DhruvTrehan03/Stretchy/Images/iCloud Photos/iCloud Photos/IMG_7711.JPEG

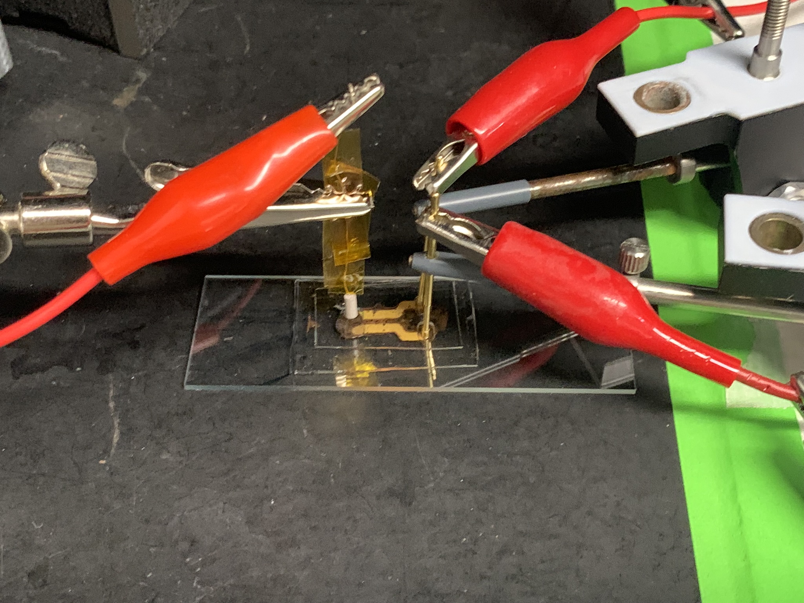
Images/iCloud Photos/iCloud Photos/IMG_7711.JPEG
