DhruvTrehan03/Stretchy/Images/iCloud Photos/iCloud Photos/IMG_7752.JPEG

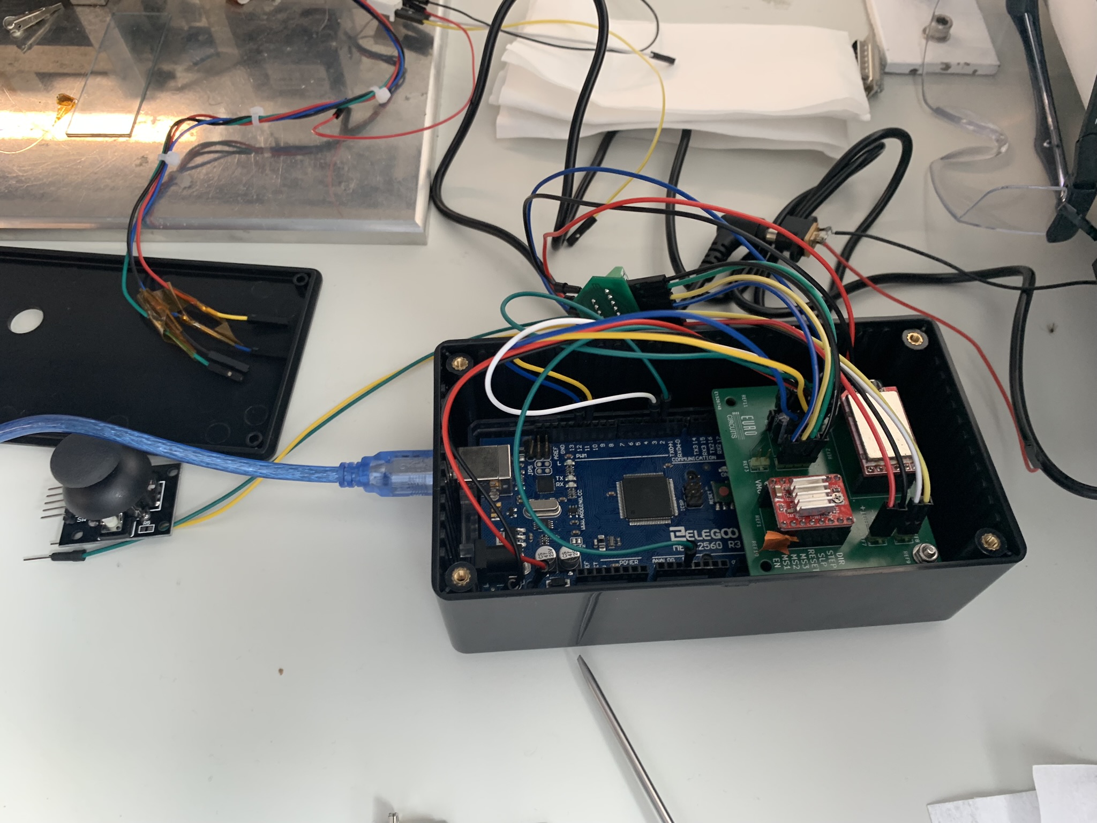
Images/iCloud Photos/iCloud Photos/IMG_7752.JPEG
