DhruvTrehan03/Stretchy/Documentation.docx

- To laser-cut the PDMS, best is to place the whole disk in the laser cutter with the die tape on it. Cut with:
  - Power: 7%
  - Speed: 2%
  - PPI: 1000
  - Z-axis: 1mm

The PDMS should be cut twice to ensure that it is fully cut.

- After the base layer has been coated with the gold (using the 3D printed template), use some PDMS to stick the top layer of PDMS onto the base layer (with the die tape still on it)
- The spin settings for both the PDMS and PEDOT is: 5 seconds at 500 rpm and 30 seconds at 1000
- Drop in the PEDOT into the holes and spin coat 3 times, placing the sample on the hot bed for approximately 30 seconds in between each coat
- After coating leave on a 150C hot plate for about 2 minutes

Using the GUI:

Select SMU unit from dropdown menu (should have INSTR)

Choose COM Port Arduino is connected to (Should be visible in device manager or in the Arduino ide)

Write Command in the format F100, D1000, B100, ensuring you use capital letters and a space between the comma and the letter, only write a number in the data points section
