DhruvTrehan03/Stretchy/Images/iCloud Photos/iCloud Photos/IMG_7627.JPEG

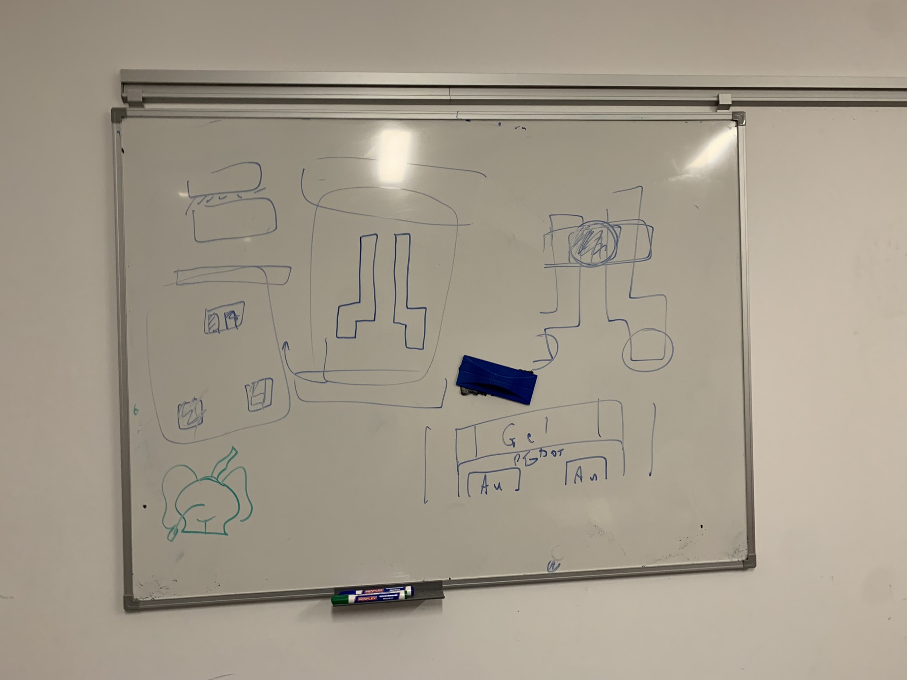
Images/iCloud Photos/iCloud Photos/IMG_7627.JPEG
