DhruvTrehan03/Stretchy/Images/iCloud Photos/iCloud Photos/IMG_7643.JPEG

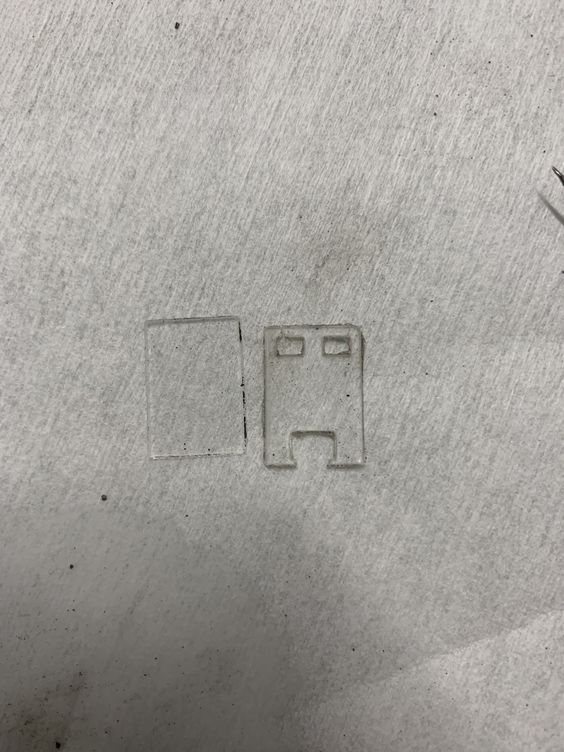
Images/iCloud Photos/iCloud Photos/IMG_7643.JPEG
