DhruvTrehan03/Stretchy/Images/iCloud Photos/iCloud Photos/IMG_7647.JPEG

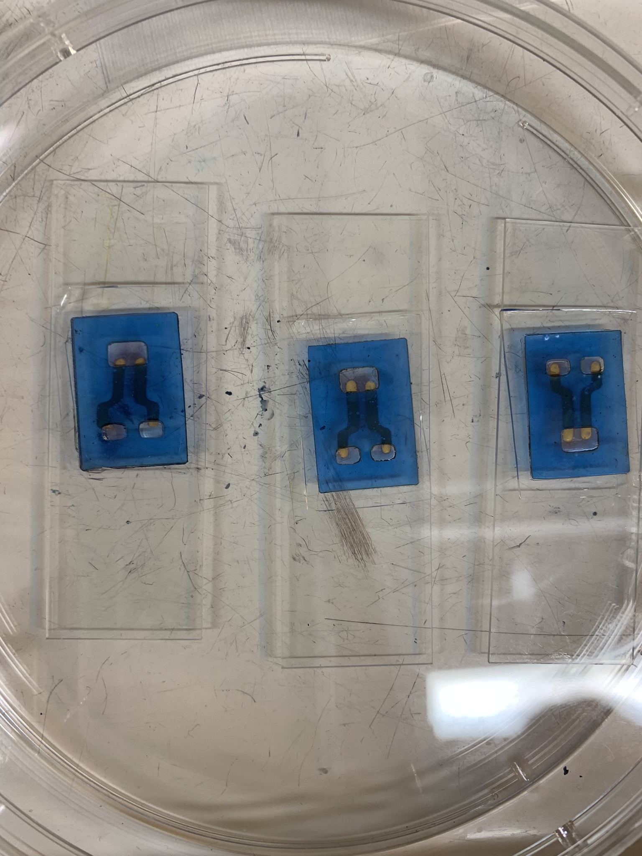
Images/iCloud Photos/iCloud Photos/IMG_7647.JPEG
