DhruvTrehan03/Stretchy/Images/iCloud Photos/iCloud Photos/IMG_7648.JPEG

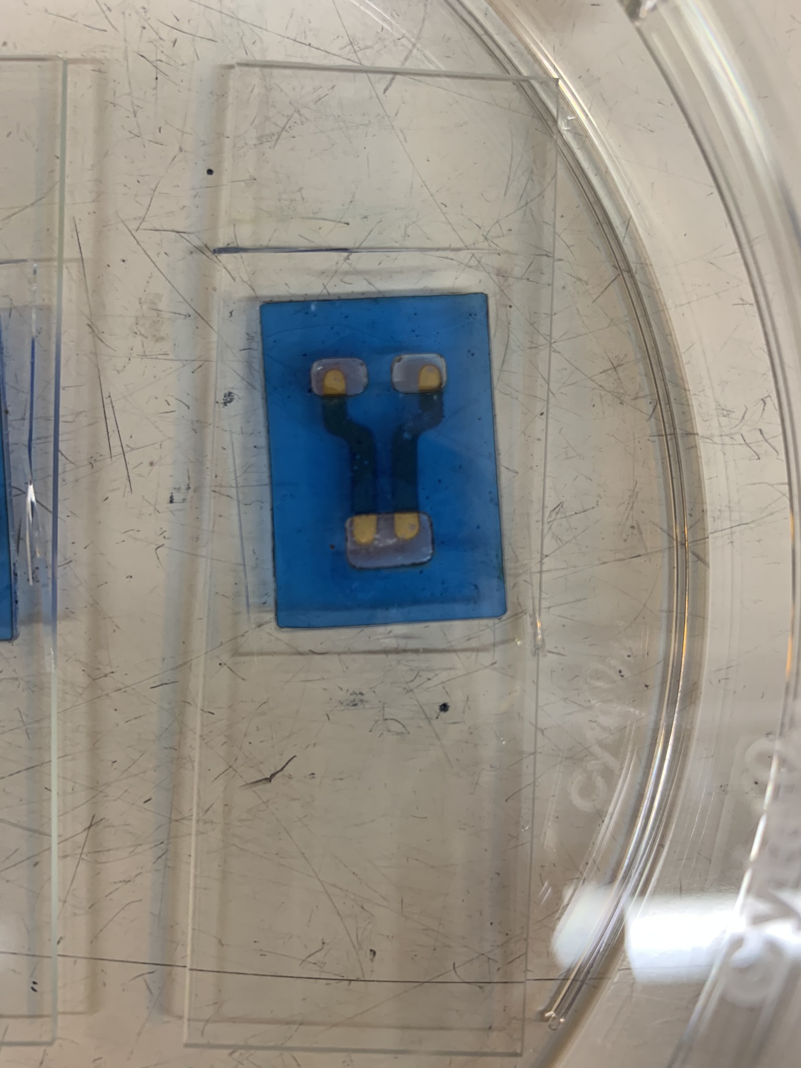
Images/iCloud Photos/iCloud Photos/IMG_7648.JPEG
