DhruvTrehan03/Stretchy/Images/iCloud Photos/iCloud Photos/IMG_7704.JPEG

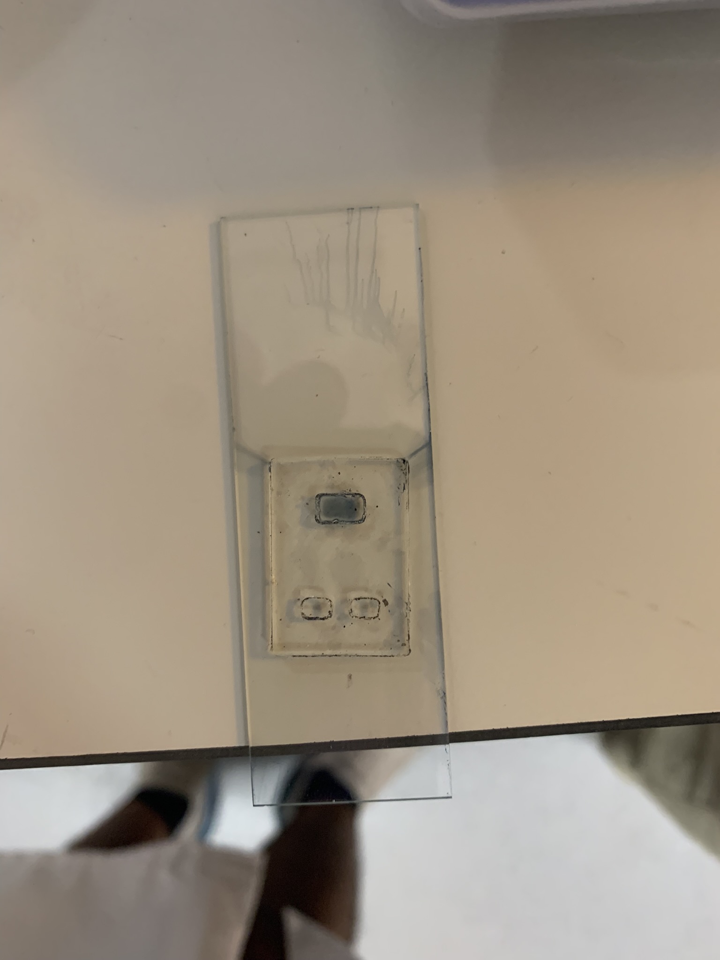
Images/iCloud Photos/iCloud Photos/IMG_7704.JPEG
