DhruvTrehan03/Stretchy/Images/iCloud Photos/iCloud Photos/IMG_7705.JPEG

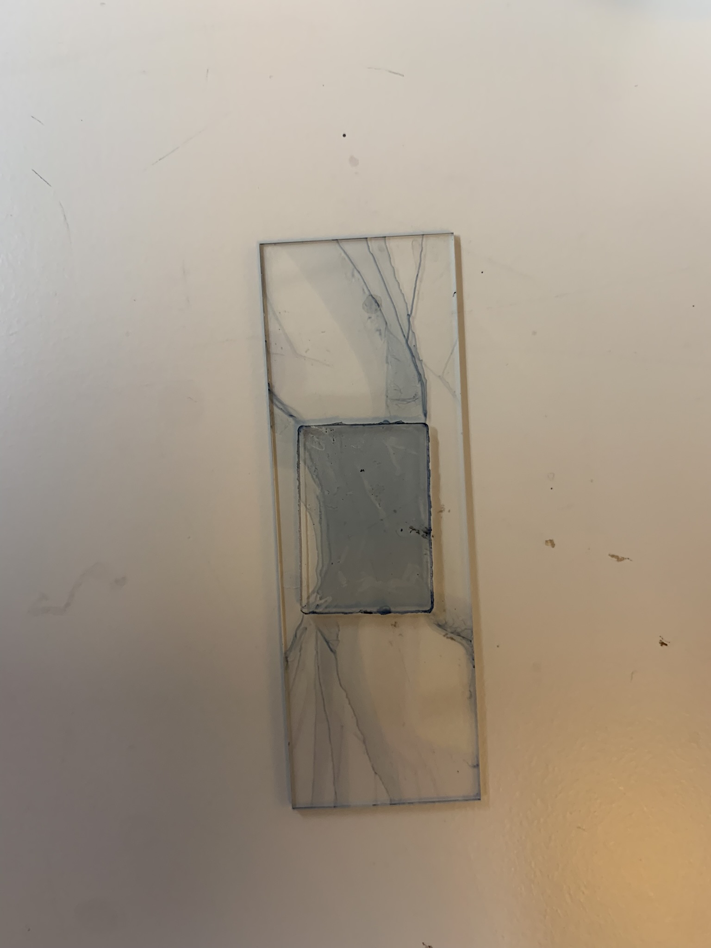
Images/iCloud Photos/iCloud Photos/IMG_7705.JPEG
