DhruvTrehan03/Stretchy/Images/iCloud Photos/iCloud Photos/IMG_7708.JPEG

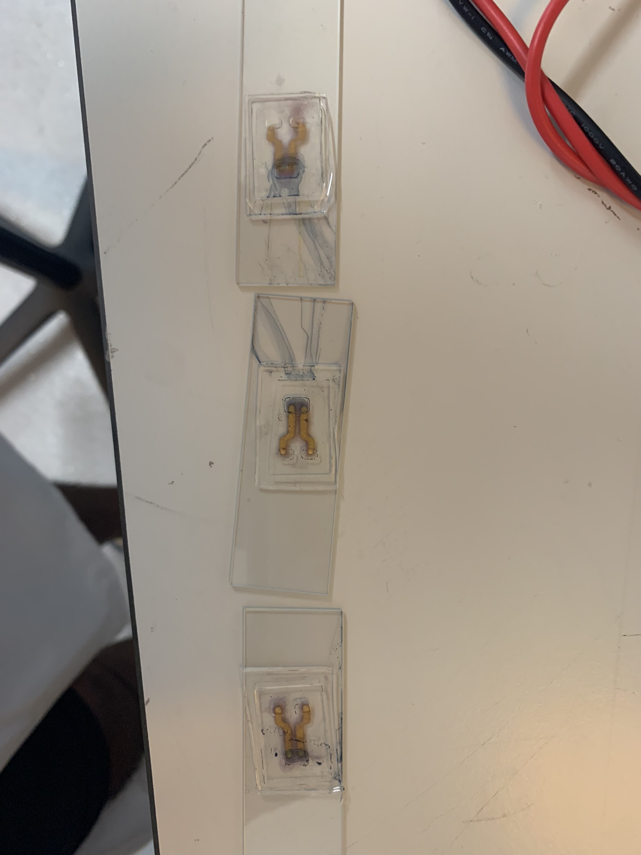
Images/iCloud Photos/iCloud Photos/IMG_7708.JPEG
