DhruvTrehan03/Stretchy/Images/iCloud Photos/iCloud Photos/IMG_7710.JPEG

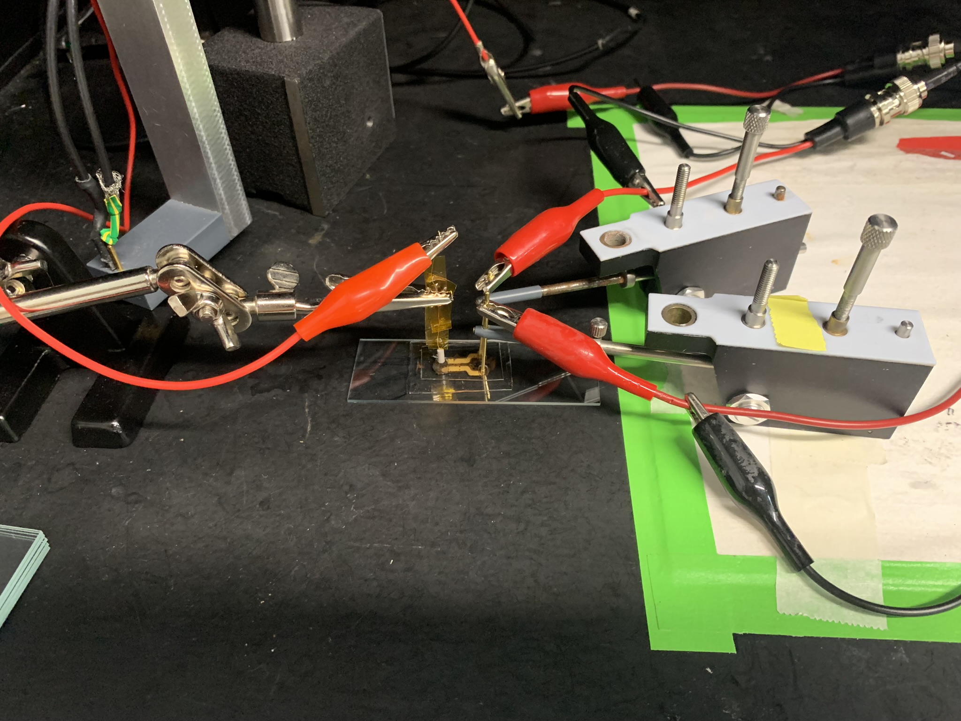
Images/iCloud Photos/iCloud Photos/IMG_7710.JPEG
