DhruvTrehan03/Stretchy/Images/iCloud Photos/iCloud Photos/IMG_7751.JPEG

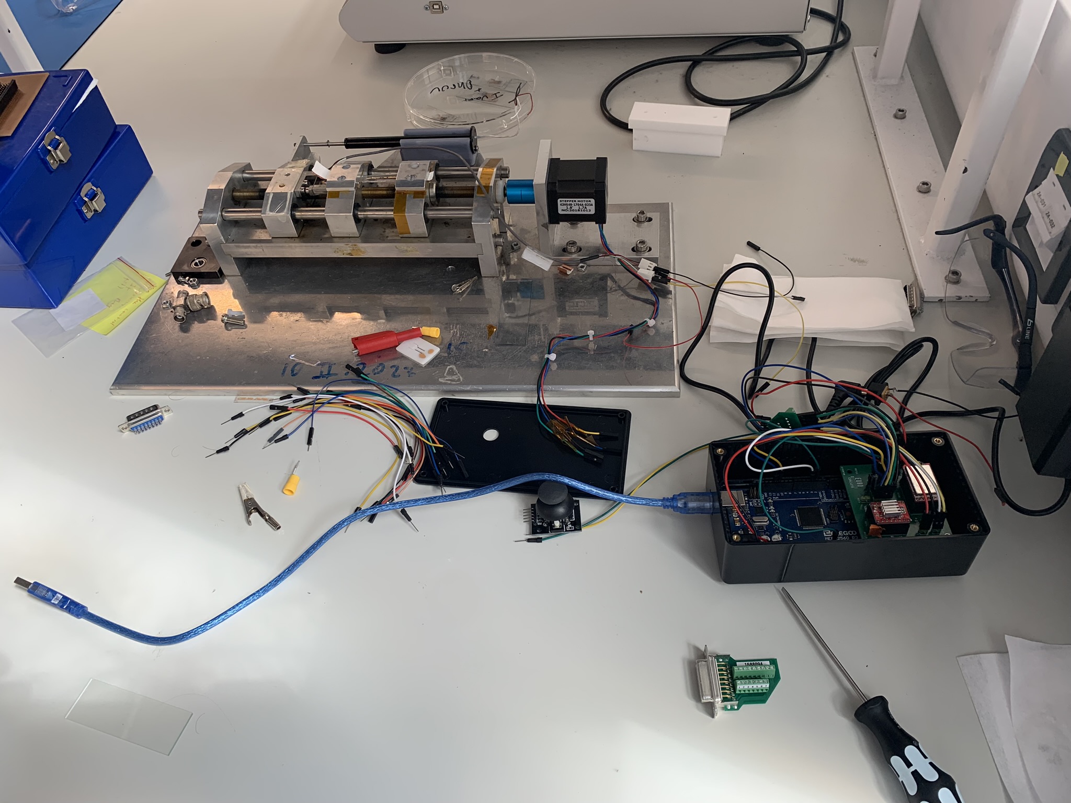
Images/iCloud Photos/iCloud Photos/IMG_7751.JPEG
