DhruvTrehan03/Stretchy/Images/iCloud Photos/iCloud Photos/IMG_7753.JPEG

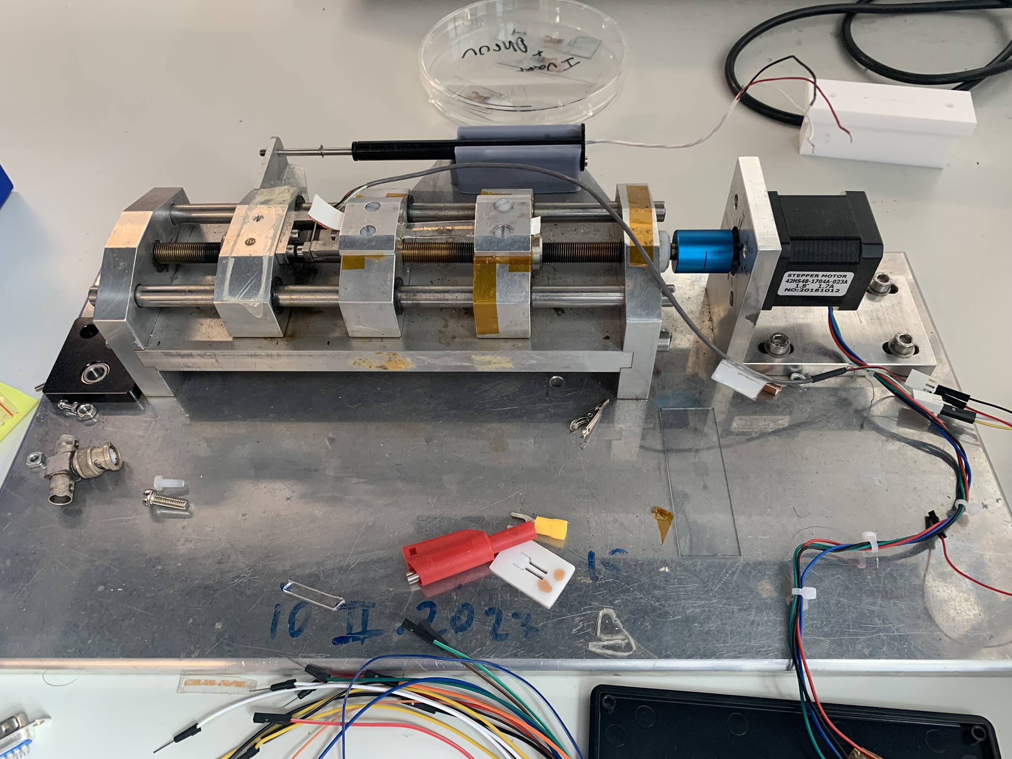
Images/iCloud Photos/iCloud Photos/IMG_7753.JPEG
