DhruvTrehan03/Stretchy/Electrode_sketch.dxf

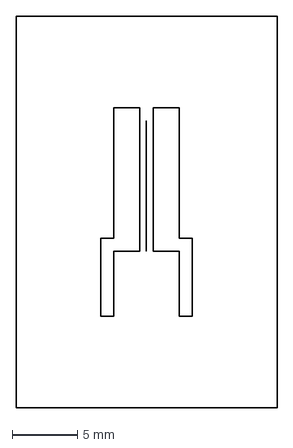
[picture p16: CAD file, 2024-07-11]
Electrode_sketch.dxf
20.0 x 30.0 mm
