DhruvTrehan03/Stretchy/Component2 v1.stl

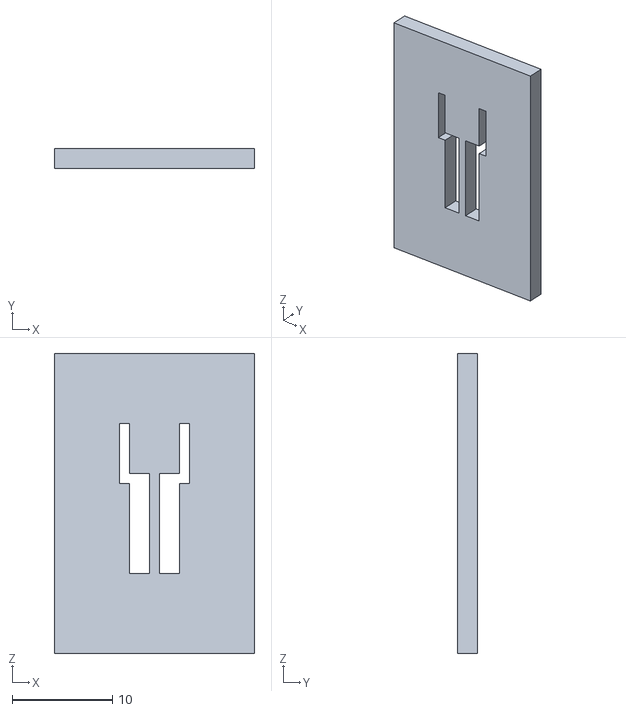
[picture p17: CAD file, 2024-07-11]
Component2 v1.stl
20.0 x 2.00 x 30.0
