DhruvTrehan03/Stretchy/(list of files, cad)

Other CAD files:
Electrode v2.stl
Electrodes v1.stl
