DhruvTrehan03/Stretchy/ArduinoGUI2Code/arduinoGUI2.py

from Tkinter import *
import arduinoCommsB as aC
import atexit

#=========================
#  code to ensure a cleaan exit

def exit_handler():
    print 'My application is ending!'
    cD.stopListening()
    aC.closeSerial()

atexit.register(exit_handler)

#===========================
# global variables for this module

ledAstatus = 0
ledBstatus = 0
servoPos = 10

tkArd = Tk()
tkArd.minsize(width=320, height=170)
tkArd.config(bg = 'yellow')
tkArd.title("Arduino GUI Demo")

	# the next line must come after  tkArd = Tk() so that a StringVar()
	#   can be created in checkForData.
import arduinoCheckForData as cD # so we can refer to its variables

#======================
# get first view ready

def setupView():
	global masterframe
	masterframe = Frame(bg = "yellow")
	masterframe.pack()
	
	selectPort()
		
#======================
# definition of screen to choose the Serial Port

def selectPort():
	global masterframe, radioVar
	for child in masterframe.winfo_children():
		child.destroy()
	radioVar = StringVar()

	lst = aC.listSerialPorts()
	
	l1= Label(masterframe, width = 5, height = 2, bg = "yellow") 
	l1.pack()

	if len(lst) > 0:
		for n in lst:
			r1 = Radiobutton(masterframe, text=n, variable=radioVar, value=n, bg = "yellow")
			r1.config(command = radioBtnPress)
			r1.pack(anchor=W)
	else:
		l2 = Label(masterframe, text = "No Serial Port Found")
		l2.pack()


#======================
# definition of main screen to control Arduino
	
def mainScreen():
	global masterframe
	for child in masterframe.winfo_children():
		child.destroy()
		
	labelA = Label(masterframe, width = 5, height = 2, bg = "yellow") 
	labelB = Label(masterframe, width = 5, bg = "yellow") 
	labelC = Label(masterframe, width = 5, bg = "yellow") 
	
	ledAbutton = Button(masterframe, text="LedA", fg="white", bg="black")
	ledAbutton.config(command = lambda: btnA(ledAbutton))
	
	ledBbutton = Button(masterframe, text="LedB", fg="white", bg="black")
	ledBbutton.config(command = lambda:  btnB(ledBbutton))
	
	slider = Scale(masterframe, from_=10, to=170, orient=HORIZONTAL)
	slider.config(command = slide)
	
	labelD = Label(masterframe, width = 5, bg = "yellow") 
	labelE= Label(masterframe, textvariable = cD.displayVal) 
	
	labelA.grid(row = 0)
	ledAbutton.grid(row = 1)
	labelB.grid(row = 1, column = 2)
	ledBbutton.grid(row = 1, column = 3)
	labelC.grid(row = 2)
	slider.grid(row = 3, columnspan = 4)
	labelD.grid(row = 4)
	labelE.grid(row = 5, columnspan = 4)
	
#=========================
# various callback functions
	
def btnA(btn):
	global ledAstatus, ledBstatus, servoPos
	
	if ledAstatus == 0:
		ledAstatus = 1
		btn.config(bg="white", fg="black")
	else:
		ledAstatus = 0
		btn.config(fg="white", bg="black")
	aC.valToArduino(ledAstatus, ledBstatus, servoPos)

def btnB(btn):
	global ledAstatus, ledBstatus, servoPos
	
	if ledBstatus == 0:
		ledBstatus = 1
		btn.config(bg="white", fg="black")
	else:
		ledBstatus = 0
		btn.config(fg="white", bg="black")
	aC.valToArduino(ledAstatus, ledBstatus, servoPos)


def slide(sval):
	global ledAstatus, ledBstatus, servoPos
	
	servoPos = sval
	aC.valToArduino(ledAstatus, ledBstatus, servoPos)

def radioBtnPress():
	global radioVar
	aC.setupSerial(radioVar.get())
	cD.listenForData()
	mainScreen()

#======================
# code to start the whole process

setupView()
tkArd.mainloop()	
