DhruvTrehan03/Stretchy/Pot_Test.ino

//#define Pot A0
//  
//void setup() {
//  Serial.begin(115200);
//  Serial.setTimeout(1);
//  }
//
//void loop() {
//  int data = analogRead(Pot);
//  float data_2 = 50 - (data * 50)/1023;
//  Serial.println(data_2);
//
//}
